PRITVARMORA/Function_generator/README.md

# Pocket Function_generator
  The project was aiming to learn the analog approach of circuit designing from scratch provides almost all types of features like, sine, triangular, square, TTL, ext./Int. PWM conversion, adjustable DC offset and variable amplitude (0.3 to 20V p-p) with variable frequency within various frequency ranges. The small design having up to 50Ω load driving capacity.
# Folder: Simulation_file
  This folder contains simulation files for multisim.
# Folder: Documentation 
  This folder contains the documentation of circuit designing and photos of simulation.
