PRITVARMORA/Function_generator/Documentation/1.png

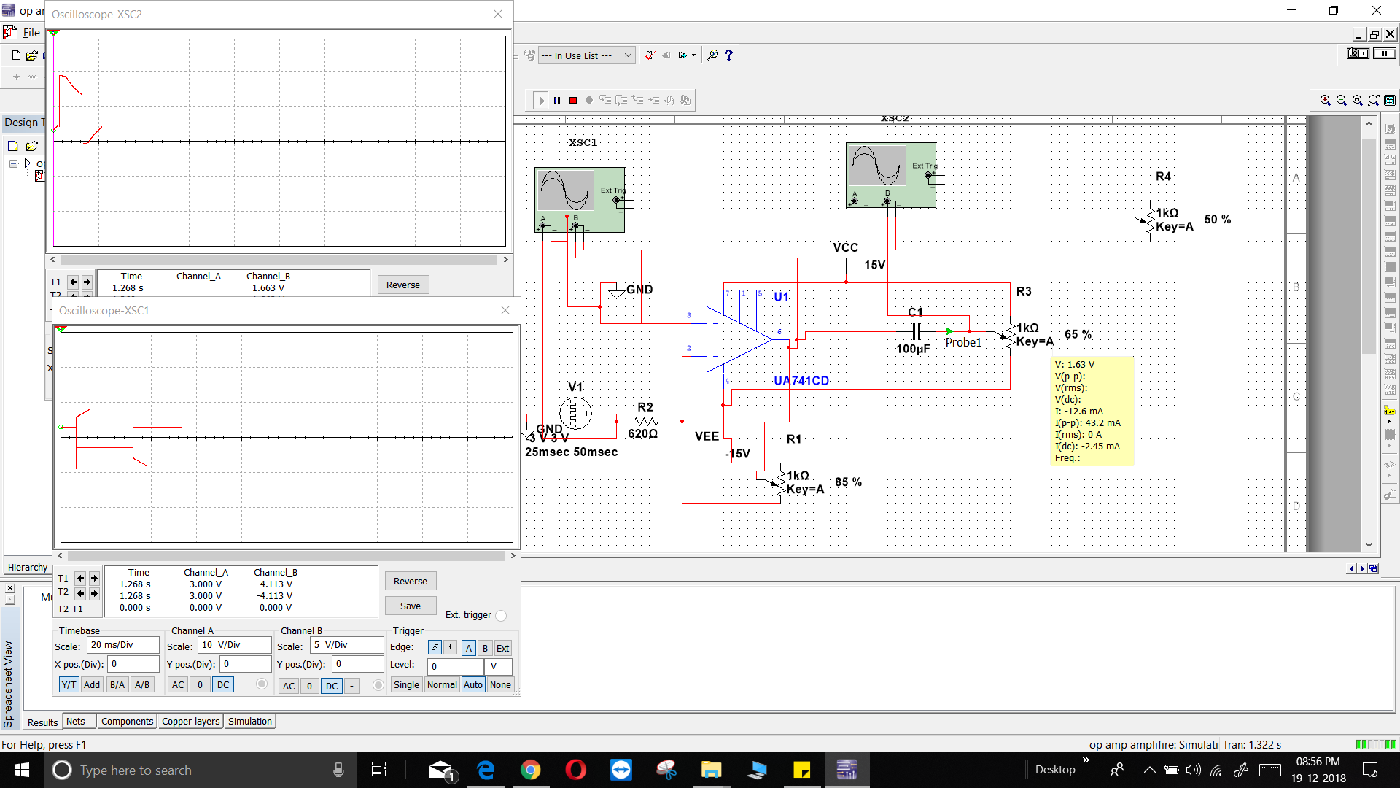
Documentation/1.png
