PRITVARMORA/Function_generator/(list of files, drawings)

Other design files:
Simulation_files/Design1.ms12
